kb-elmo/67mk_E/firmware/README.md

# 67mk_E - Vial-QMK

67mk_e

A simple "no frills" drop-in replacement PCB for the KBDfans 67mkII / 67lite

* Keyboard Maintainer: [kb-elmo](https://github.com/kb-elmo)
* Hardware Supported: 67mk_E rev.1 PCB
* Hardware Availability: [Open source project](https://github.com/kb-elmo/67mk_e)

Make example for this keyboard (after setting up your build environment):

    make kb_elmo/67mk_e:default

Flashing example for this keyboard:

    make kb_elmo/67mk_e:default:flash

**Bootloader:** Press the physical reset button on the bottom side of the PCB (labeled Reset) or hold down the top left key while plugging in the board.

See the [build environment setup](https://docs.qmk.fm/#/getting_started_build_tools) and the [make instructions](https://docs.qmk.fm/#/getting_started_make_guide) for more information. Brand new to QMK? Start with our [Complete Newbs Guide](https://docs.qmk.fm/#/newbs).
