kb-elmo/67mk_E/plates/ISO.dxf

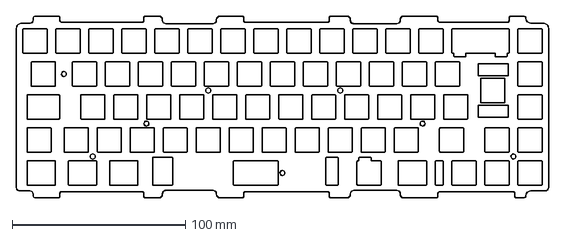
[picture p3: CAD file, 2021-08-08]
plates/ISO.dxf
307.3 x 104.9 mm
