kb-elmo/67mk_E/plates/ANSI.dxf

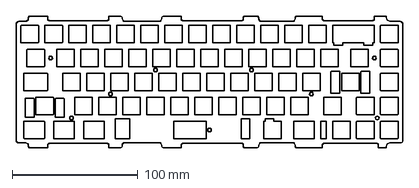
[picture p4: CAD file, 2021-08-08]
plates/ANSI.dxf
307.3 x 104.9 mm
