kb-elmo/67mk_E/pcb/67_E.sch

## KiCad design pcb/67_E.sch (2021-08-03)

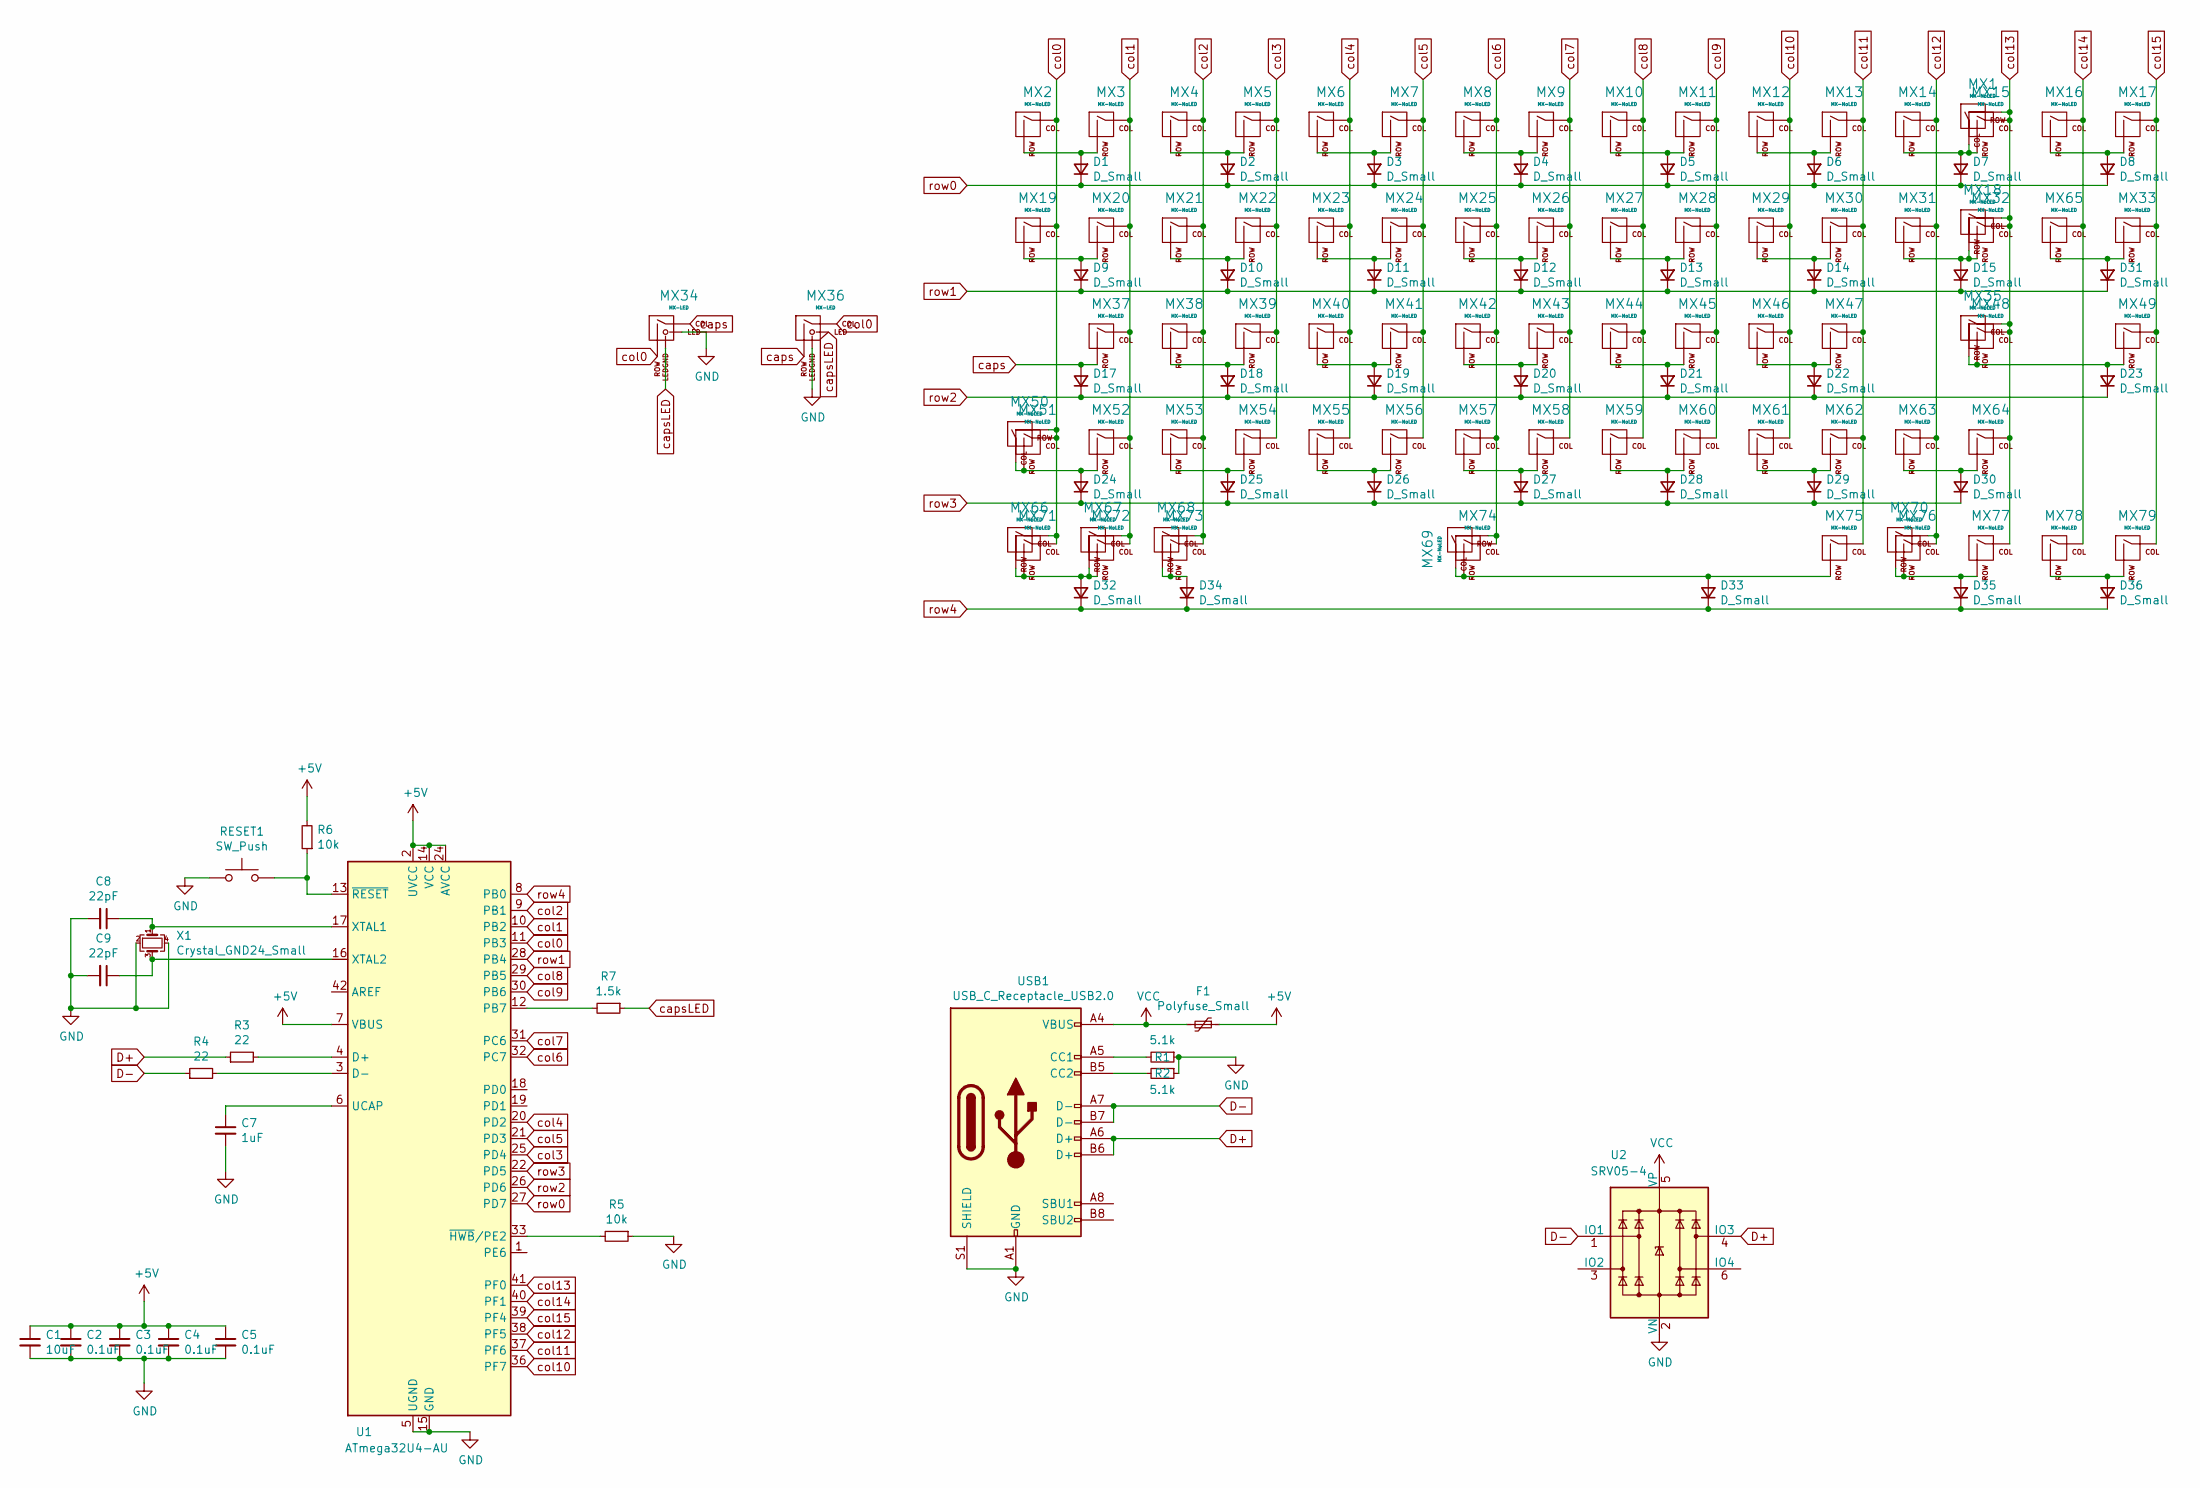
[picture p5: schematic 67_E.sch]

Parts:
C1: 10uF; C_0805_2012Metric; LCSC C91245
C2, C3, C4, C5: 0.1uF; C_0805_2012Metric; LCSC C49678
C7: 1uF; C_0805_2012Metric; LCSC C28323
C8, C9: 22pF; C_0805_2012Metric; LCSC C1804
D1, D2, D3, D4, D5, D6, D7, D8, D9, D10, D11, D12, D13, D14, D15, D17, D18, D19, D20, D21, D22, D23, D24, D25, D26, D27, D28, D29, D30, D31, D32, D33, D34, D35, D36: D_Small; D_SOT-23_ANK; LCSC C68978
F1: Polyfuse_Small; Fuse_1206_3216Metric; LCSC C69688
MX1: MX-NoLED; MXOnly-2U-NoLED
MX2, MX3, MX4, MX5, MX6, MX7, MX8, MX9, MX10, MX11, MX12, MX13, MX14, MX15, MX16, MX17, MX18, MX20, MX21, MX22, MX23, MX24, MX25, MX26, MX27, MX28, MX29, MX30, MX31, MX33, MX37, MX38, MX39, MX40, MX41, MX42, MX43, MX44, MX45, MX46, MX47, MX49, MX52, MX53, MX54, MX55, MX56, MX57, MX58, MX59, MX60, MX61, MX62, MX64, MX65, MX67, MX77, MX78, MX79: MX-NoLED; MXOnly-1U-NoLED
MX19, MX32, MX66, MX68, MX70: MX-NoLED; MXOnly-1.5U-NoLED
MX34: MX-LED; MXOnly-1.25U-flipped-LED
MX35: MX-NoLED; MXOnly-ISO-ReversedStabilizers-NoLED
MX36: MX-LED; MXOnly-1.75U
MX48, MX51: MX-NoLED; MXOnly-2.25U-NoLED
MX50, MX71, MX72, MX73, MX75, MX76: MX-NoLED; MXOnly-1.25U-NoLED
MX63: MX-NoLED; MXOnly-1.75U-NoLED
MX69: MX-NoLED; MXOnly-7U-ReversedStabilizers-NoLED
MX74: MX-NoLED; MXOnly-6.25U-ReversedStabilizers-NoLED
R1, R2: 5.1k; R_0805_2012Metric; LCSC C27834
R3, R4: 22; R_0805_2012Metric; LCSC C17561
R5, R6: 10k; R_0805_2012Metric; LCSC C17414
R7: 1.5k; R_0805_2012Metric; LCSC C4310
RESET1: SW_Push; SW_SPST_TL3342; LCSC C318884
U1: ATmega32U4-AU; TQFP-44_10x10mm_P0.8mm; LCSC C44854
U2: SRV05-4; SOT-23-6; LCSC C85364
USB1: USB_C_Receptacle_USB2.0; USB_C_Receptacle_HRO_TYPE-C-31-M-12; LCSC C165948
X1: Crystal_GND24_Small; Crystal_SMD_3225-4Pin_3.2x2.5mm; LCSC C13738

Connections:
+5V: C1.1, C2.1, C3.1, C4.1, C5.1, F1.1, R6.2, U1.2 (UVCC), U1.7 (VBUS), U1.14 (VCC), U1.24 (AVCC), U1.34 (VCC), U1.44 (AVCC)
D+: R3.1, U2.4 (IO3), USB1.A6 (D+), USB1.B6 (D+)
D-: R4.1, U2.1 (IO1), USB1.A7 (D-), USB1.B7 (D-)
GND: C1.2, C2.2, C3.2, C4.2, C5.2, C7.2, C8.2, C9.2, MX34.3 (LED), MX36.4 (LEDGND), R1.1, R2.1, R5.1, RESET1.1, U1.5 (UGND), U1.15 (GND), U1.23 (GND), U1.35 (GND), U1.43 (GND), U2.2 (VN), USB1.A1 (GND), USB1.A12 (GND), USB1.B1 (GND), USB1.B12 (GND), USB1.S1 (SHIELD), X1.2, X1.4
unnamed: C7.1, U1.6 (UCAP)
unnamed: C8.1, U1.17 (XTAL1), X1.1
unnamed: C9.1, U1.16 (XTAL2), X1.3
unnamed: D1.2 (A), MX2.2 (ROW), MX3.2 (ROW)
unnamed: D2.2 (A), MX4.2 (ROW), MX5.2 (ROW)
unnamed: D3.2 (A), MX6.2 (ROW), MX7.2 (ROW)
unnamed: D4.2 (A), MX8.2 (ROW), MX9.2 (ROW)
unnamed: D5.2 (A), MX10.2 (ROW), MX11.2 (ROW)
unnamed: D6.2 (A), MX12.2 (ROW), MX13.2 (ROW)
unnamed: D7.2 (A), MX1.1 (COL), MX14.2 (ROW), MX15.2 (ROW)
unnamed: D8.2 (A), MX16.2 (ROW), MX17.2 (ROW)
unnamed: D9.2 (A), MX19.2 (ROW), MX20.2 (ROW)
unnamed: D10.2 (A), MX21.2 (ROW), MX22.2 (ROW)
unnamed: D11.2 (A), MX23.2 (ROW), MX24.2 (ROW)
unnamed: D12.2 (A), MX25.2 (ROW), MX26.2 (ROW)
unnamed: D13.2 (A), MX27.2 (ROW), MX28.2 (ROW)
unnamed: D14.2 (A), MX29.2 (ROW), MX30.2 (ROW)
unnamed: D15.2 (A), MX18.2 (ROW), MX31.2 (ROW), MX32.2 (ROW)
unnamed: D18.2 (A), MX38.2 (ROW), MX39.2 (ROW)
unnamed: D19.2 (A), MX40.2 (ROW), MX41.2 (ROW)
unnamed: D20.2 (A), MX42.2 (ROW), MX43.2 (ROW)
unnamed: D21.2 (A), MX44.2 (ROW), MX45.2 (ROW)
unnamed: D22.2 (A), MX46.2 (ROW), MX47.2 (ROW)
unnamed: D23.2 (A), MX35.2 (ROW), MX48.2 (ROW), MX49.2 (ROW)
unnamed: D24.2 (A), MX50.1 (COL), MX51.2 (ROW), MX52.2 (ROW)
unnamed: D25.2 (A), MX53.2 (ROW), MX54.2 (ROW)
unnamed: D26.2 (A), MX55.2 (ROW), MX56.2 (ROW)
unnamed: D27.2 (A), MX57.2 (ROW), MX58.2 (ROW)
unnamed: D28.2 (A), MX59.2 (ROW), MX60.2 (ROW)
unnamed: D29.2 (A), MX61.2 (ROW), MX62.2 (ROW)
unnamed: D30.2 (A), MX63.2 (ROW), MX64.2 (ROW)
unnamed: D31.2 (A), MX33.2 (ROW), MX65.2 (ROW)
unnamed: D32.2 (A), MX66.2 (ROW), MX67.2 (ROW), MX71.2 (ROW), MX72.2 (ROW)
unnamed: D33.2 (A), MX69.1 (COL), MX74.2 (ROW), MX75.2 (ROW)
unnamed: D34.2 (A), MX68.2 (ROW), MX73.2 (ROW)
unnamed: D35.2 (A), MX70.2 (ROW), MX76.2 (ROW), MX77.2 (ROW)
unnamed: D36.2 (A), MX78.2 (ROW), MX79.2 (ROW)
unnamed: R1.2, USB1.A5 (CC1)
unnamed: R2.2, USB1.B5 (CC2)
unnamed: R3.2, U1.4 (D+)
unnamed: R4.2, U1.3 (D-)
unnamed: R5.2, U1.33 (~HWB~/PE2)
unnamed: R6.1, RESET1.2, U1.13 (~RESET)
unnamed: R7.2, U1.12 (PB7)
VCC: F1.2, U2.5 (VP), USB1.A4 (VBUS), USB1.A9 (VBUS), USB1.B4 (VBUS), USB1.B9 (VBUS)
caps: D17.2 (A), MX34.1 (COL), MX36.2 (ROW), MX37.2 (ROW)
capsLED: MX34.4 (LEDGND), MX36.3 (LED), R7.1
col0: MX2.1 (COL), MX19.1 (COL), MX34.2 (ROW), MX36.1 (COL), MX50.2 (ROW), MX51.1 (COL), MX66.1 (COL), MX71.1 (COL), U1.11 (PB3)
col1: MX3.1 (COL), MX20.1 (COL), MX37.1 (COL), MX52.1 (COL), MX67.1 (COL), MX72.1 (COL), U1.10 (PB2)
col2: MX4.1 (COL), MX21.1 (COL), MX38.1 (COL), MX53.1 (COL), MX68.1 (COL), MX73.1 (COL), U1.9 (PB1)
col3: MX5.1 (COL), MX22.1 (COL), MX39.1 (COL), MX54.1 (COL), U1.25 (PD4)
col4: MX6.1 (COL), MX23.1 (COL), MX40.1 (COL), MX55.1 (COL), U1.20 (PD2)
col5: MX7.1 (COL), MX24.1 (COL), MX41.1 (COL), MX56.1 (COL), U1.21 (PD3)
col6: MX8.1 (COL), MX25.1 (COL), MX42.1 (COL), MX57.1 (COL), MX69.2 (ROW), MX74.1 (COL), U1.32 (PC7)
col7: MX9.1 (COL), MX26.1 (COL), MX43.1 (COL), MX58.1 (COL), U1.31 (PC6)
col8: MX10.1 (COL), MX27.1 (COL), MX44.1 (COL), MX59.1 (COL), U1.29 (PB5)
col9: MX11.1 (COL), MX28.1 (COL), MX45.1 (COL), MX60.1 (COL), U1.30 (PB6)
col10: MX12.1 (COL), MX29.1 (COL), MX46.1 (COL), MX61.1 (COL), U1.36 (PF7)
col11: MX13.1 (COL), MX30.1 (COL), MX47.1 (COL), MX62.1 (COL), MX75.1 (COL), U1.37 (PF6)
col12: MX14.1 (COL), MX31.1 (COL), MX63.1 (COL), MX70.1 (COL), MX76.1 (COL), U1.38 (PF5)
col13: MX1.2 (ROW), MX15.1 (COL), MX18.1 (COL), MX32.1 (COL), MX35.1 (COL), MX48.1 (COL), MX64.1 (COL), MX77.1 (COL), U1.41 (PF0)
col14: MX16.1 (COL), MX65.1 (COL), MX78.1 (COL), U1.40 (PF1)
col15: MX17.1 (COL), MX33.1 (COL), MX49.1 (COL), MX79.1 (COL), U1.39 (PF4)
row0: D1.1 (K), D2.1 (K), D3.1 (K), D4.1 (K), D5.1 (K), D6.1 (K), D7.1 (K), D8.1 (K), U1.27 (PD7)
row1: D9.1 (K), D10.1 (K), D11.1 (K), D12.1 (K), D13.1 (K), D14.1 (K), D15.1 (K), D31.1 (K), U1.28 (PB4)
row2: D17.1 (K), D18.1 (K), D19.1 (K), D20.1 (K), D21.1 (K), D22.1 (K), D23.1 (K), U1.26 (PD6)
row3: D24.1 (K), D25.1 (K), D26.1 (K), D27.1 (K), D28.1 (K), D29.1 (K), D30.1 (K), U1.22 (PD5)
row4: D32.1 (K), D33.1 (K), D34.1 (K), D35.1 (K), D36.1 (K), U1.8 (PB0)
