kb-elmo/67mk_E/(commit log)

2021-08-06 update gerbers and fab files
    [67_E-B_Cu.gbr, 67_E-B_Mask.gbr, 67_E-B_Paste.gbr, 67_E-B_SilkS.gbr, 67_E-Edge_Cuts.gbr, 67_E-F_Cu.gbr, 67_E-F_Mask.gbr, 67_E-F_Paste.gbr]
2021-08-08 added plates
    [ANSI.dxf, ISO.dxf]
