kb-elmo/67mk_E/(notices)

Notices in the files:
README.md:
CC BY-NC-SA 4.0
